mehrdad2200/LightOS-ESP32/docs/images/device-front-ight.jpg

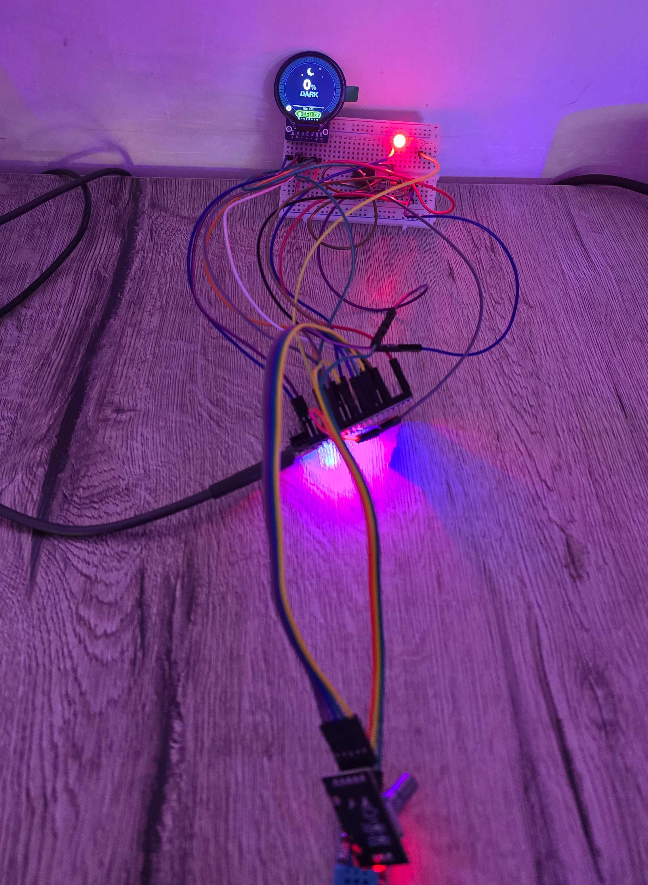
docs/images/device-front-ight.jpg
