mehrdad2200/LightOS-ESP32/docs/images/device-front.jpg

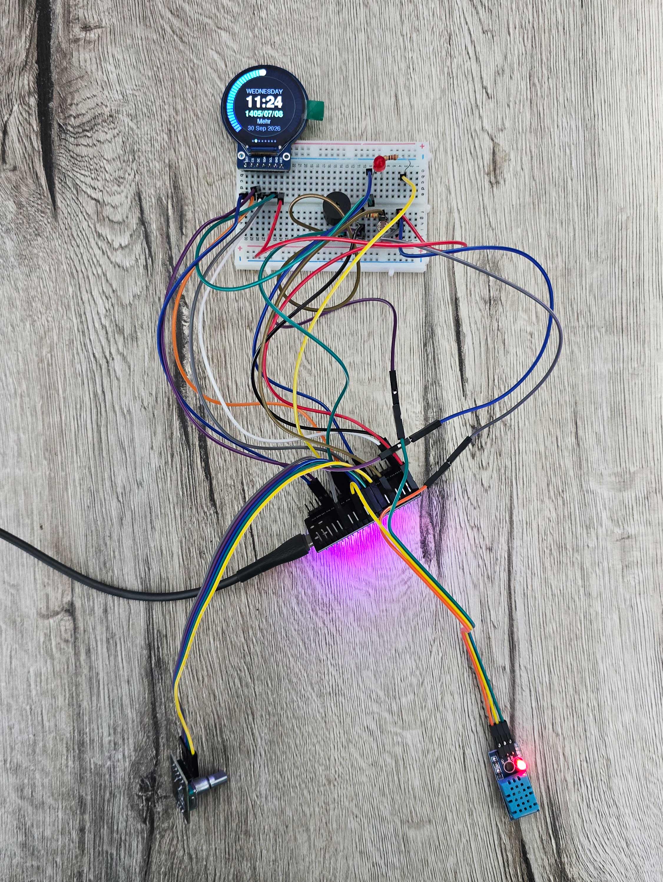
docs/images/device-front.jpg
